MabrozKhan/rfid-plattenspieler/cad/fit_tests/round1/overview.png

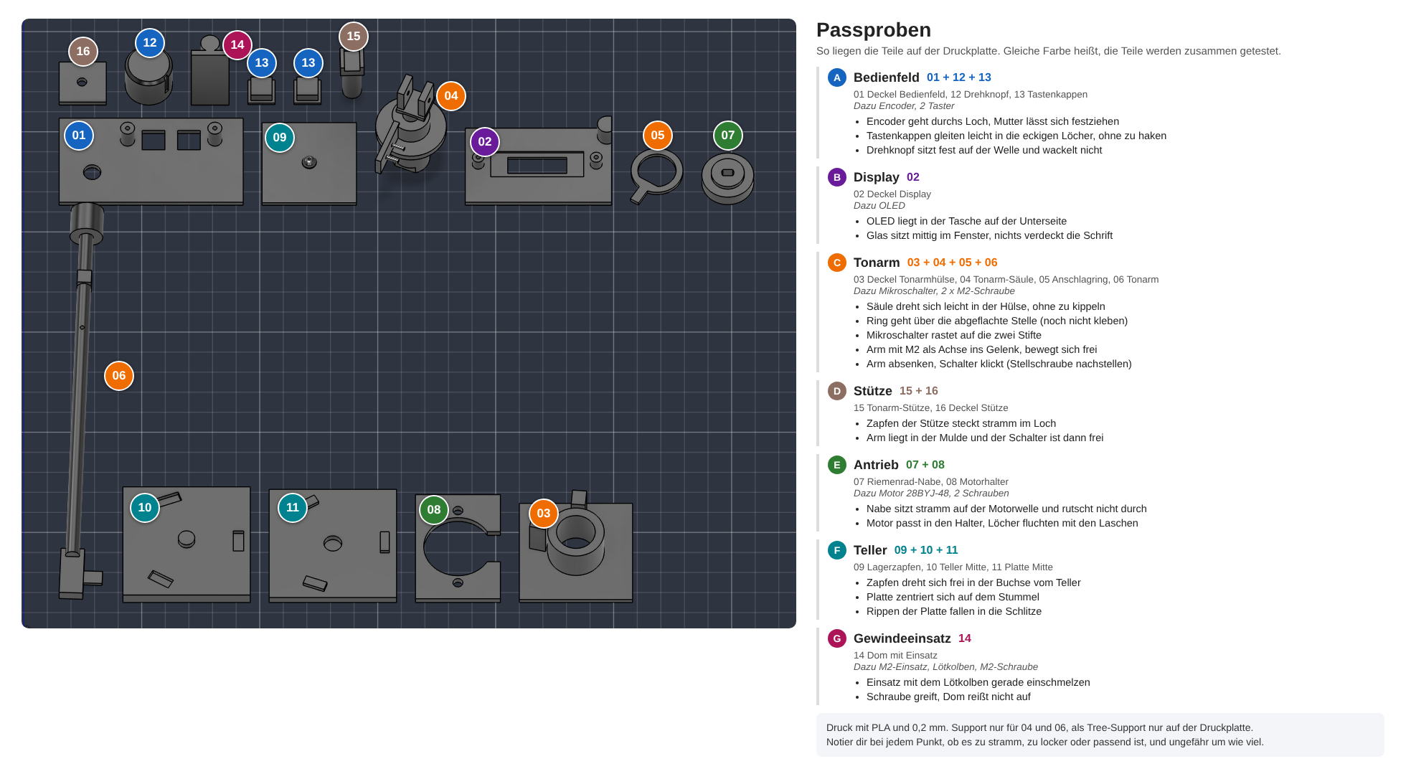
cad/fit_tests/round1/overview.png
