MabrozKhan/rfid-plattenspieler/cad/druck/19_Tastenkappe_Zurueck_links_schwarz.stl

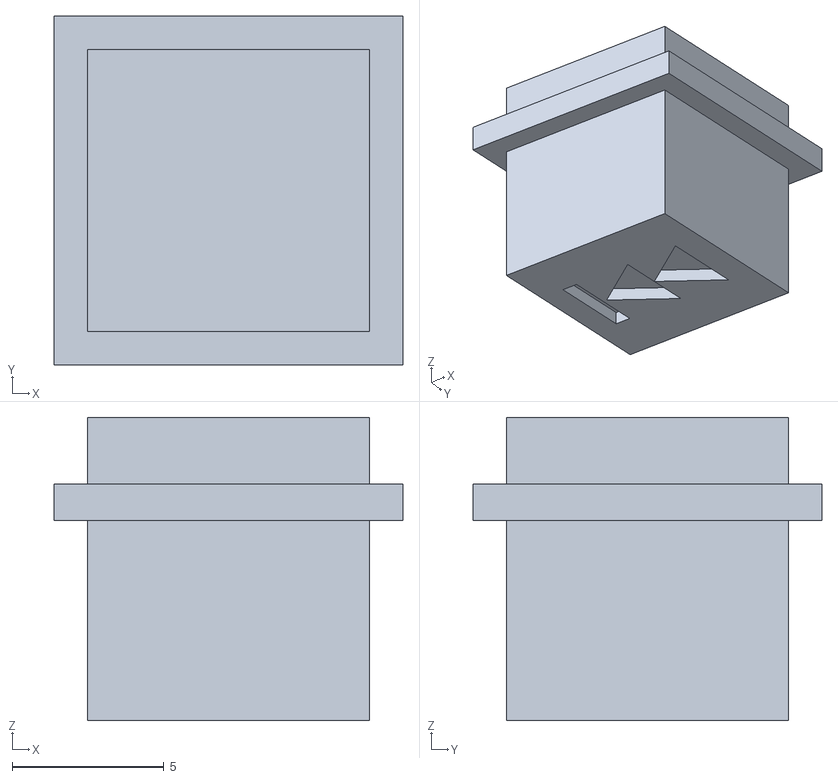
[picture p5: CAD file, 2026-10-21]
cad/druck/19_Tastenkappe_Zurueck_links_schwarz.stl
11.5 x 11.5 x 10.0
