MabrozKhan/rfid-plattenspieler/cad/fit_tests/round1/plattenspieler_passproben.3mf

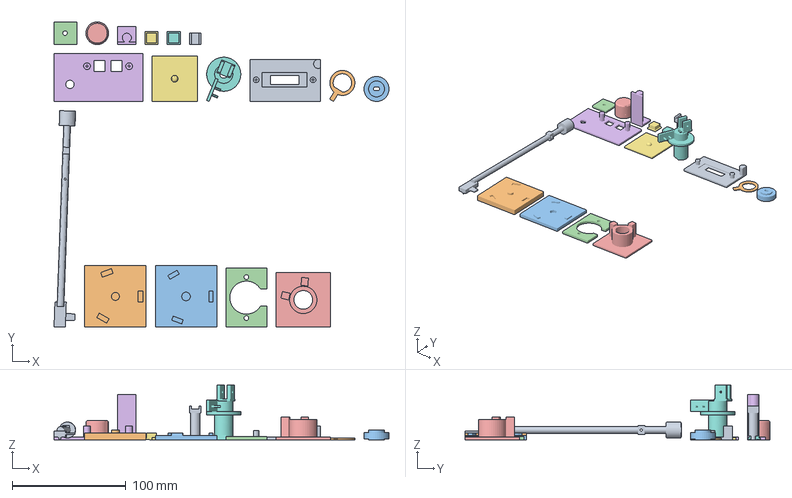
[picture p6: CAD file, 2026-10-11]
cad/fit_tests/round1/plattenspieler_passproben.3mf
294.3 x 268.3 x 48.0 mm
06_Tonarm_Arm
10_Teller_Mitte
11_Platte_Mitte
08_Motorhalter
03_Deckel_Tonarm
01_Deckel_Bedienung
09_Lagerzapfen
04_Tonarm_Saeule
02_Deckel_Display
05_Tonarm_Anschlagring
07_Riemenrad_Nabe
16_Deckel_Stuetze
12_Drehknopf
14_Dom_Einsatz
13_Tastenkappe_1
13_Tastenkappe_2
15_Tonarm_Stuetze
