MabrozKhan/rfid-plattenspieler/cad/fit_tests/round1/stl/07_Riemenrad_Nabe.stl

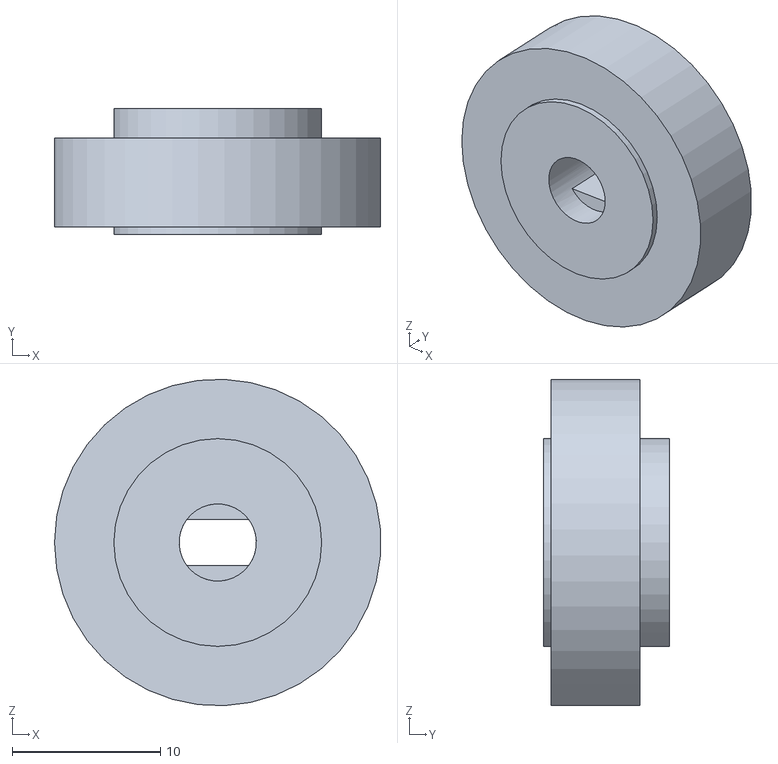
[picture p7: CAD file, 2026-10-11]
cad/fit_tests/round1/stl/07_Riemenrad_Nabe.stl
22.0 x 8.50 x 22.0
