MabrozKhan/rfid-plattenspieler/cad/fit_tests/round2/plattenspieler_tonarm.3mf

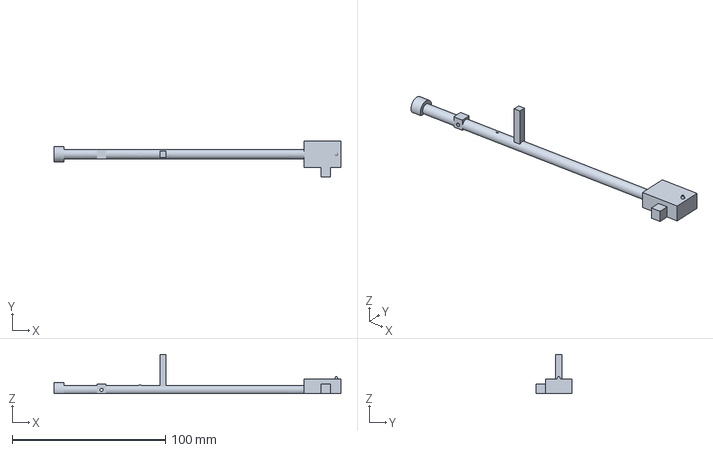
[picture p8: CAD file, 2026-10-12]
cad/fit_tests/round2/plattenspieler_tonarm.3mf
187.0 x 23.8 x 25.6 mm
