MabrozKhan/rfid-plattenspieler/cad/fit_tests/round2/stl/11_Tastenkappe_Test_unten_1-8mm.stl

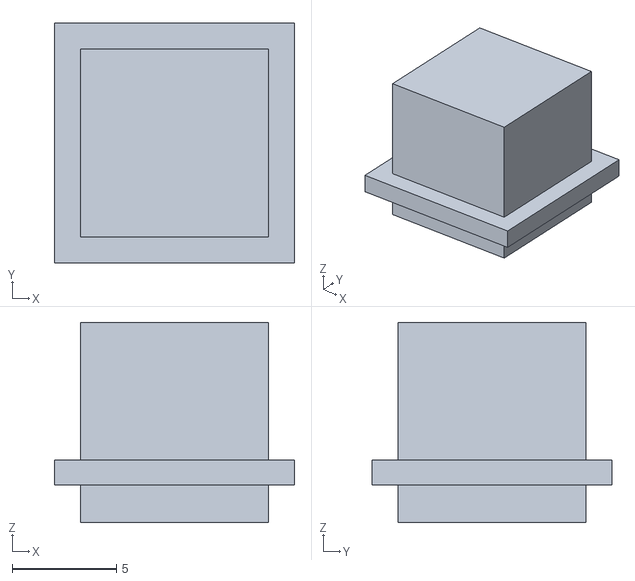
[picture p9: CAD file, 2026-10-21]
cad/fit_tests/round2/stl/11_Tastenkappe_Test_unten_1-8mm.stl
11.5 x 11.5 x 9.60
