MabrozKhan/rfid-plattenspieler/cad/print/06b_switch_lever_shim_5x6x1-8_grey.stl

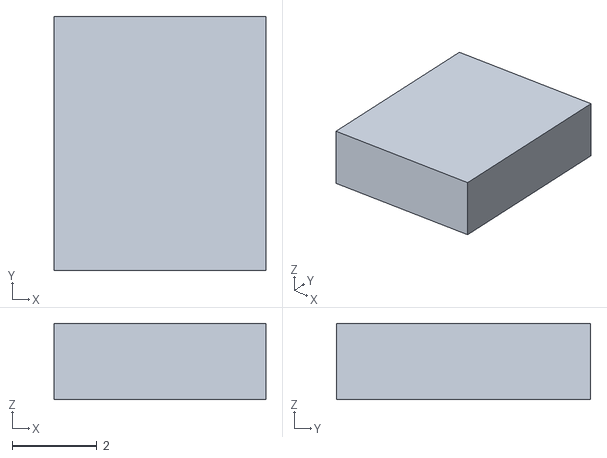
[picture p10: CAD file, 2026-10-23]
cad/print/06b_switch_lever_shim_5x6x1-8_grey.stl
5.00 x 6.00 x 1.80
