MabrozKhan/rfid-plattenspieler/cad/fit_tests/round1/stl/09_Lagerzapfen.stl

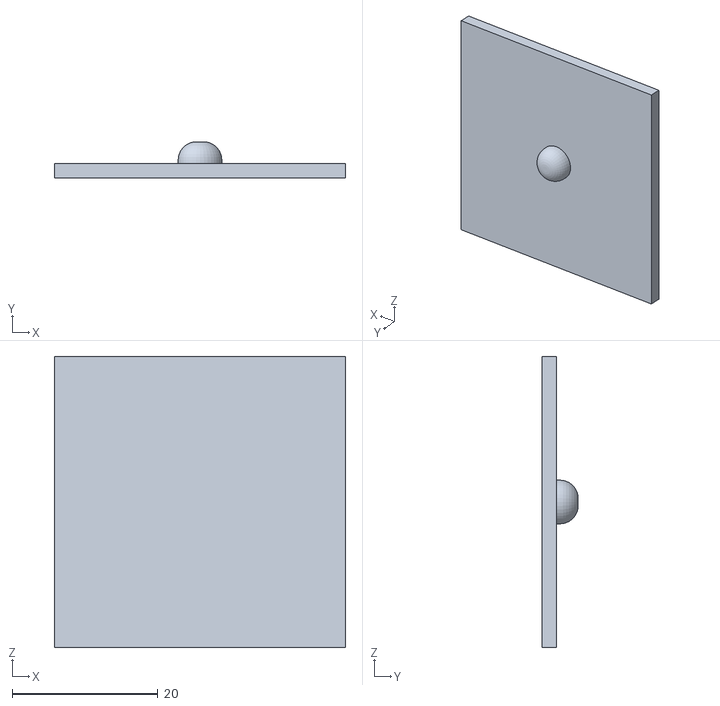
[picture p11: CAD file, 2026-10-11]
cad/fit_tests/round1/stl/09_Lagerzapfen.stl
40.0 x 5.00 x 40.0
