MabrozKhan/rfid-plattenspieler/cad/fit_tests/round2/m2_stift_20mm.stl

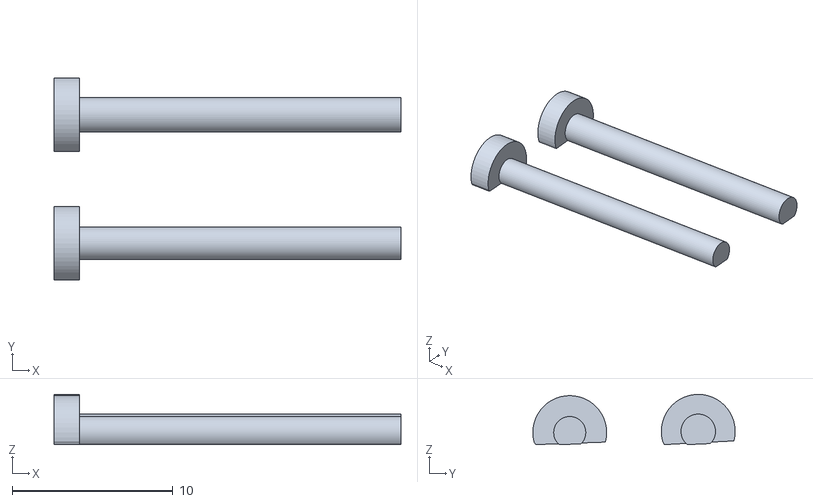
[picture p12: CAD file, 2026-10-12]
cad/fit_tests/round2/m2_stift_20mm.stl
21.6 x 12.6 x 3.12
