MabrozKhan/rfid-plattenspieler/cad/fit_tests/round2/stl/10_Tastenkappe_Test_unten_2-2mm.stl

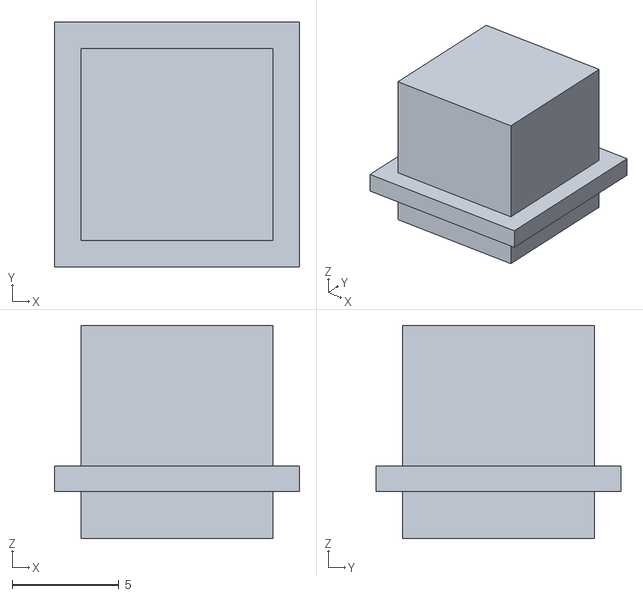
[picture p13: CAD file, 2026-10-21]
cad/fit_tests/round2/stl/10_Tastenkappe_Test_unten_2-2mm.stl
11.5 x 11.5 x 10.0
