MabrozKhan/rfid-plattenspieler/cad/print/04b_thrust_ring_grey.stl

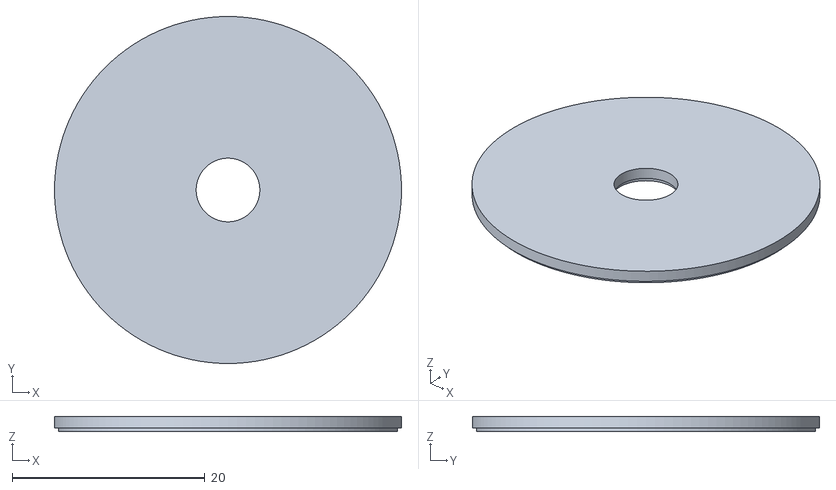
[picture p14: CAD file, 2026-10-23]
cad/print/04b_thrust_ring_grey.stl
36.0 x 36.0 x 1.60
