MabrozKhan/rfid-plattenspieler/cad/fit_tests/round1/stl/03_Deckel_Tonarm_FLIP.stl

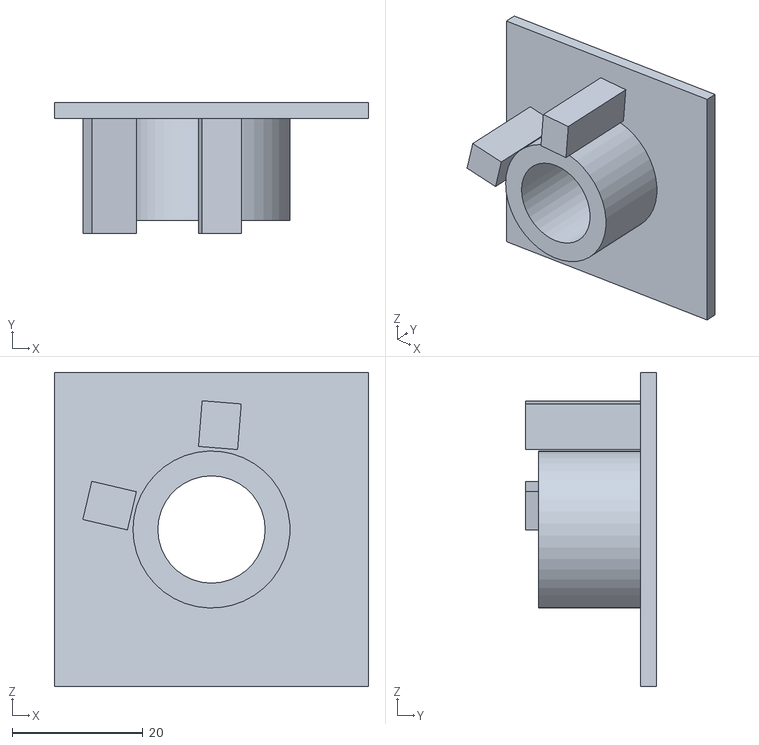
[picture p15: CAD file, 2026-10-11]
cad/fit_tests/round1/stl/03_Deckel_Tonarm_FLIP.stl
48.0 x 20.0 x 48.0
