MabrozKhan/rfid-plattenspieler/cad/fit_tests/round2/plattenspieler_passproben2.3mf

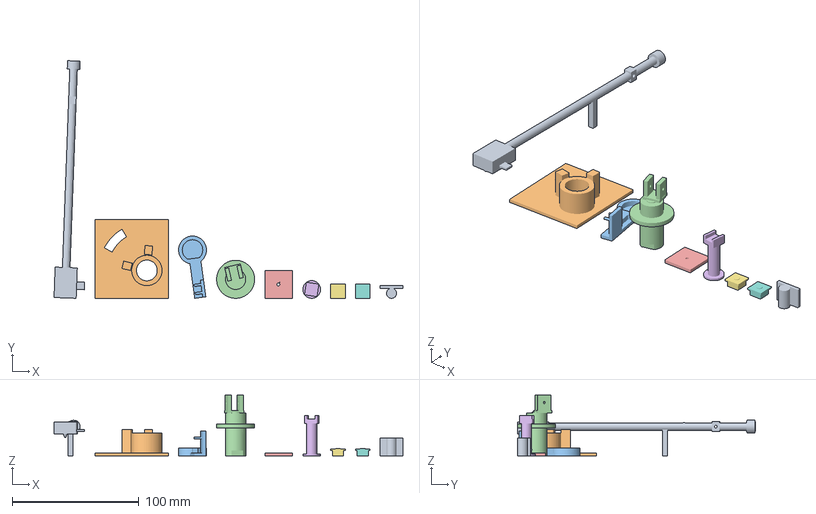
[picture p16: CAD file, 2026-10-12]
cad/fit_tests/round2/plattenspieler_passproben2.3mf
275.1 x 187.4 x 48.0 mm
04_Tonarm_Arm
01_Deckel_Tonarm_Schlitz
03_Ring_Schaltertraeger
02_Tonarm_Saeule
06_Deckel_Stuetze
05_Tonarm_Stuetze
07_Tastenkappe_1
07_Tastenkappe_2
08_Dom_Schraube
