MabrozKhan/rfid-plattenspieler/cad/print/05d_tensioner_set_grey.stl

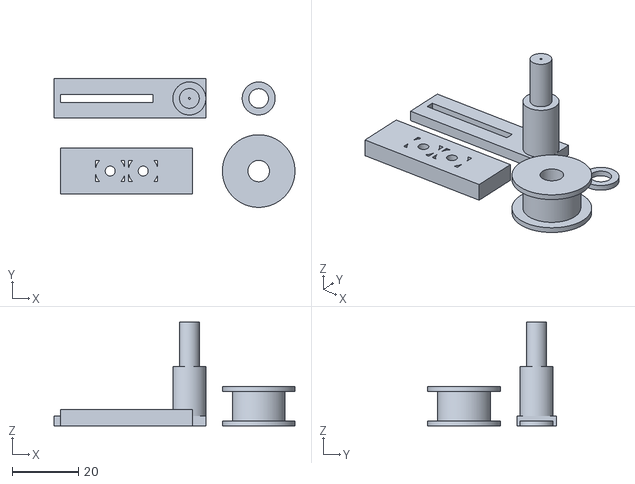
[picture p17: CAD file, 2026-10-23]
cad/print/05d_tensioner_set_grey.stl
73.0 x 39.0 x 31.5
