MabrozKhan/rfid-plattenspieler/cad/fit_tests/round1/stl/14_Dom_Einsatz_FLIP.stl

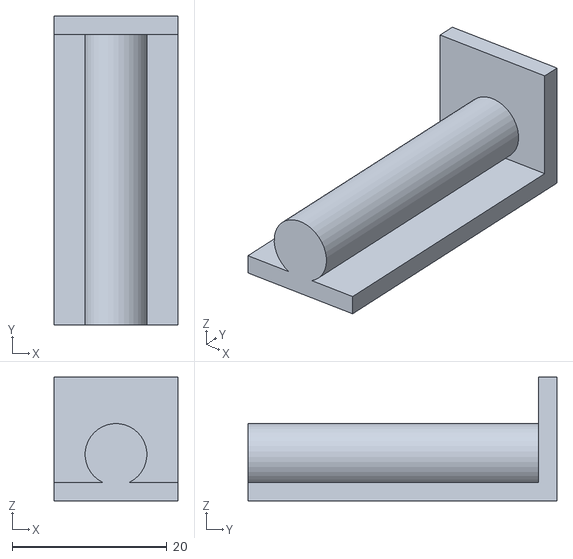
[picture p18: CAD file, 2026-10-11]
cad/fit_tests/round1/stl/14_Dom_Einsatz_FLIP.stl
16.0 x 40.0 x 16.0
