MabrozKhan/rfid-plattenspieler/cad/print/06b_switch_lever_shims_grey.stl

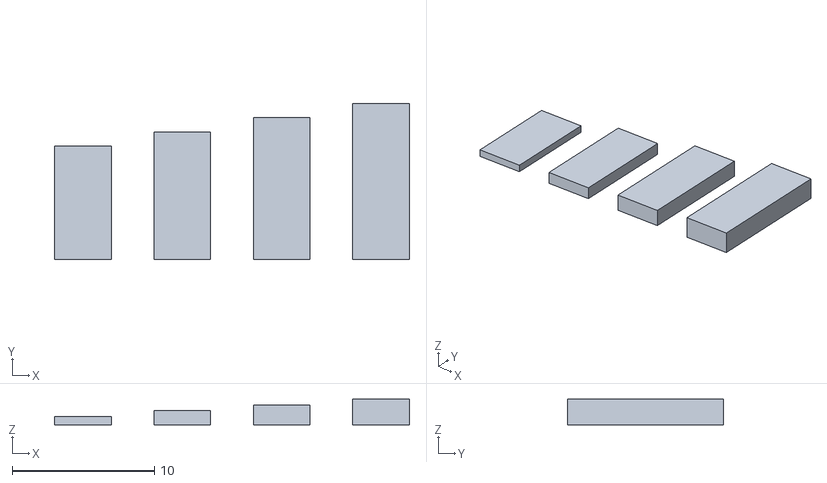
[picture p19: CAD file, 2026-10-22]
cad/print/06b_switch_lever_shims_grey.stl
25.0 x 11.0 x 1.80
