MabrozKhan/rfid-plattenspieler/cad/fit_tests/round1/stl/13_Tastenkappe_2.stl

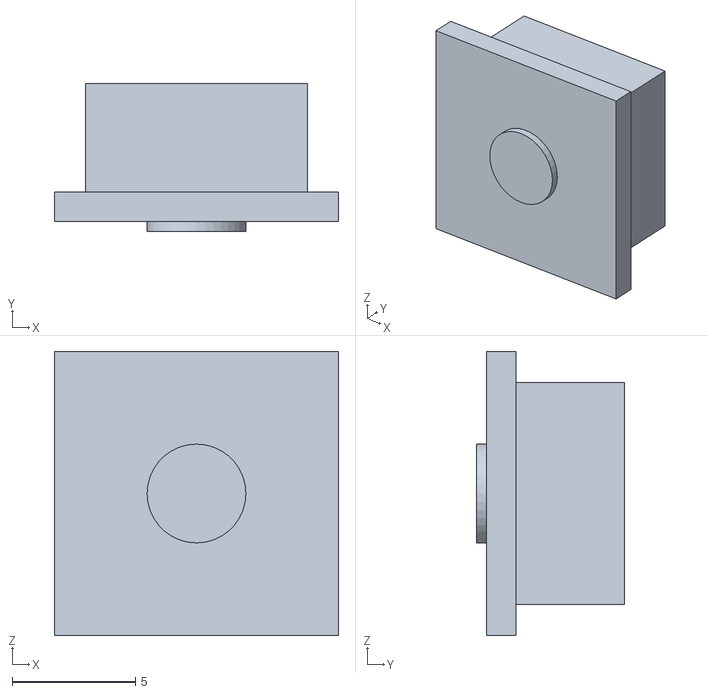
[picture p20: CAD file, 2026-10-11]
cad/fit_tests/round1/stl/13_Tastenkappe_2.stl
11.5 x 6.00 x 11.5
