MabrozKhan/rfid-plattenspieler/cad/fit_tests/round2/stl/08_Dom_Schraube.stl

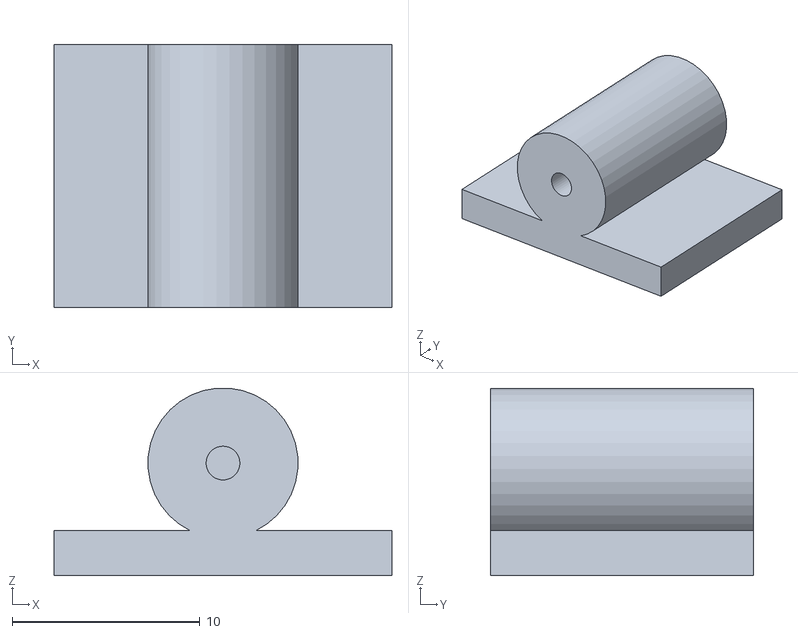
[picture p21: CAD file, 2026-10-12]
cad/fit_tests/round2/stl/08_Dom_Schraube.stl
18.0 x 14.0 x 9.98
