MabrozKhan/rfid-plattenspieler/cad/print/11b_name_plate_text_inlay_grey.stl

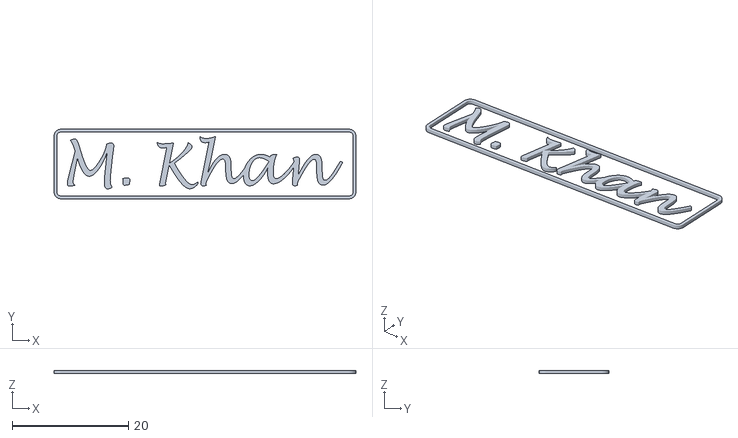
[picture p22: CAD file, 2026-10-21]
cad/print/11b_name_plate_text_inlay_grey.stl
52.0 x 12.0 x 0.6
