MabrozKhan/rfid-plattenspieler/cad/fit_tests/round1/stl/08_Motorhalter.stl

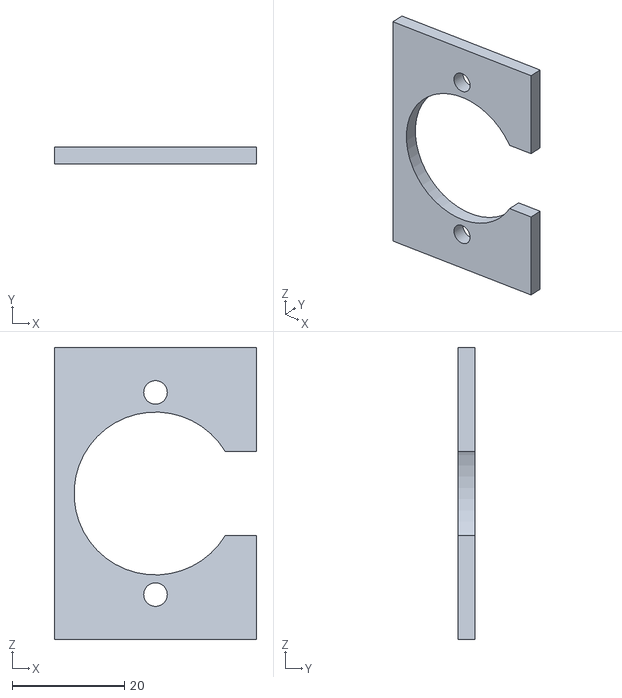
[picture p23: CAD file, 2026-10-11]
cad/fit_tests/round1/stl/08_Motorhalter.stl
36.0 x 3.00 x 52.0
