MabrozKhan/rfid-plattenspieler/cad/fit_tests/round2/stl/06_Deckel_Stuetze_FLIP.stl

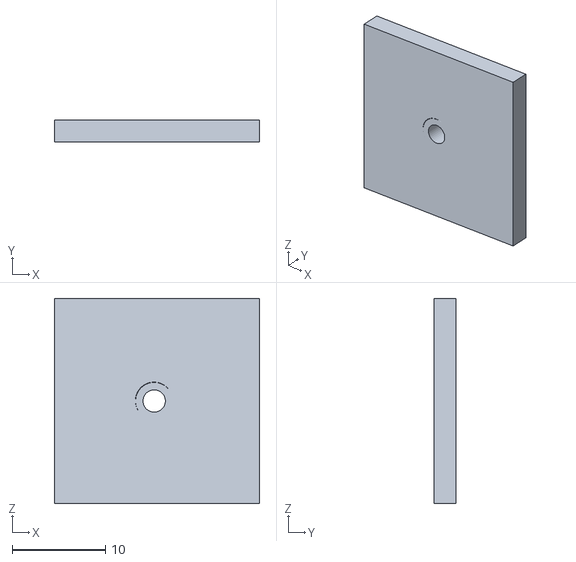
[picture p24: CAD file, 2026-10-12]
cad/fit_tests/round2/stl/06_Deckel_Stuetze_FLIP.stl
22.0 x 2.40 x 22.0
