MabrozKhan/rfid-plattenspieler/cad/fit_tests/round1/stl/04_Tonarm_Saeule.stl

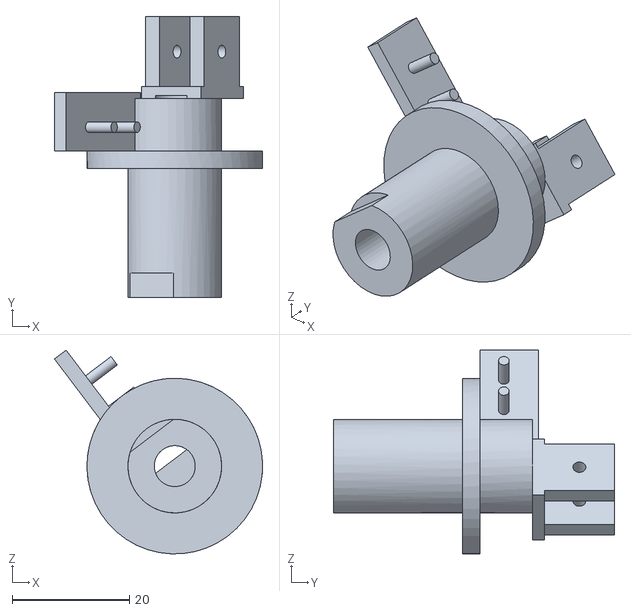
[picture p25: CAD file, 2026-10-11]
cad/fit_tests/round1/stl/04_Tonarm_Saeule.stl
35.6 x 48.0 x 34.8
