MabrozKhan/rfid-plattenspieler/cad/fit_tests/round2/stl/01_Deckel_Tonarm_Schlitz_FLIP.stl

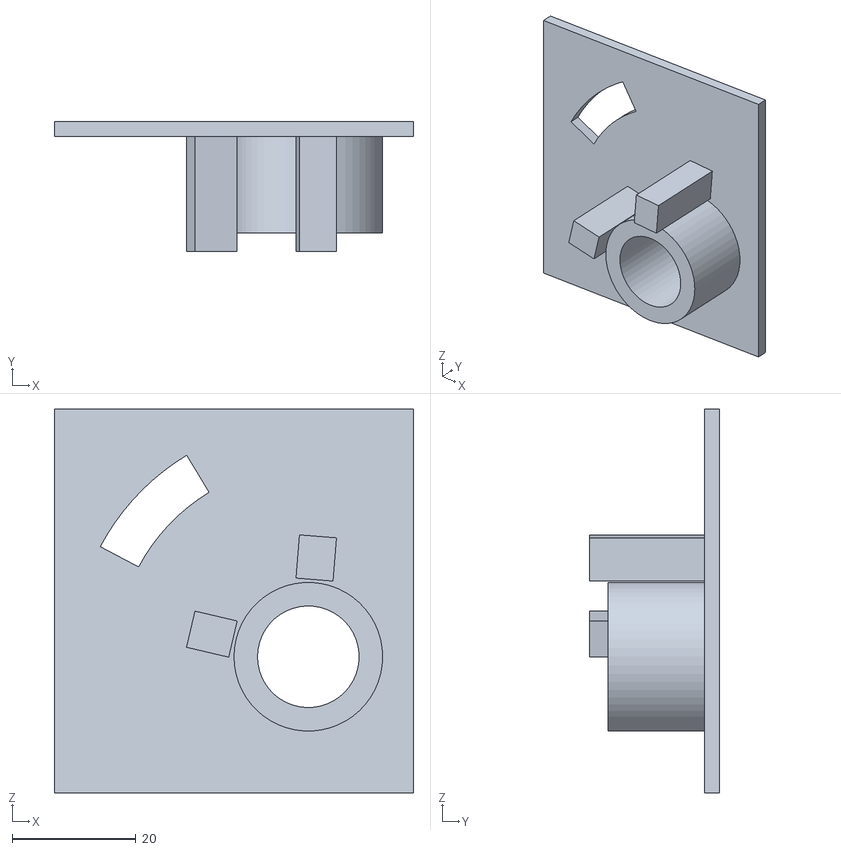
[picture p26: CAD file, 2026-10-12]
cad/fit_tests/round2/stl/01_Deckel_Tonarm_Schlitz_FLIP.stl
58.0 x 21.0 x 62.0
