MabrozKhan/rfid-plattenspieler/cad/print/12b_centre_spindle_black.stl

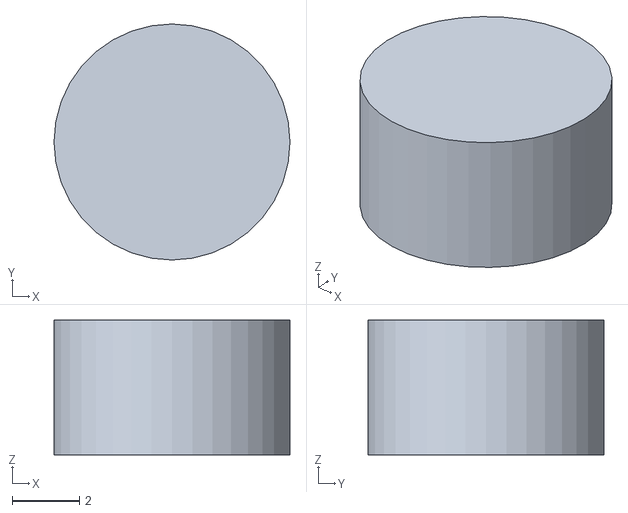
[picture p27: CAD file, 2026-10-21]
cad/print/12b_centre_spindle_black.stl
7.00 x 7.00 x 4.00
