MabrozKhan/rfid-plattenspieler/cad/fit_tests/round1/stl/15_Tonarm_Stuetze.stl

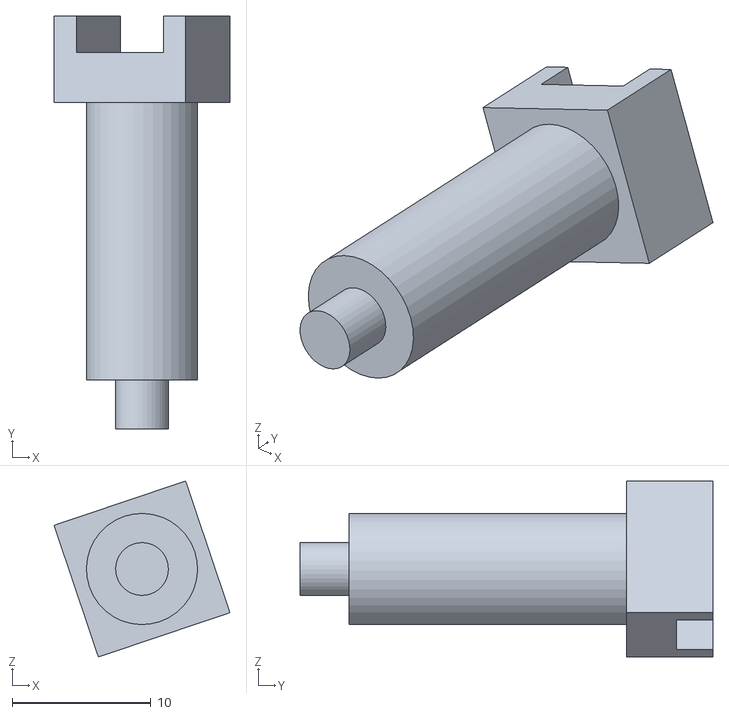
[picture p28: CAD file, 2026-10-11]
cad/fit_tests/round1/stl/15_Tonarm_Stuetze.stl
12.7 x 29.7 x 12.7
