MabrozKhan/rfid-plattenspieler/cad/fit_tests/round2/stl/02_Tonarm_Saeule.stl

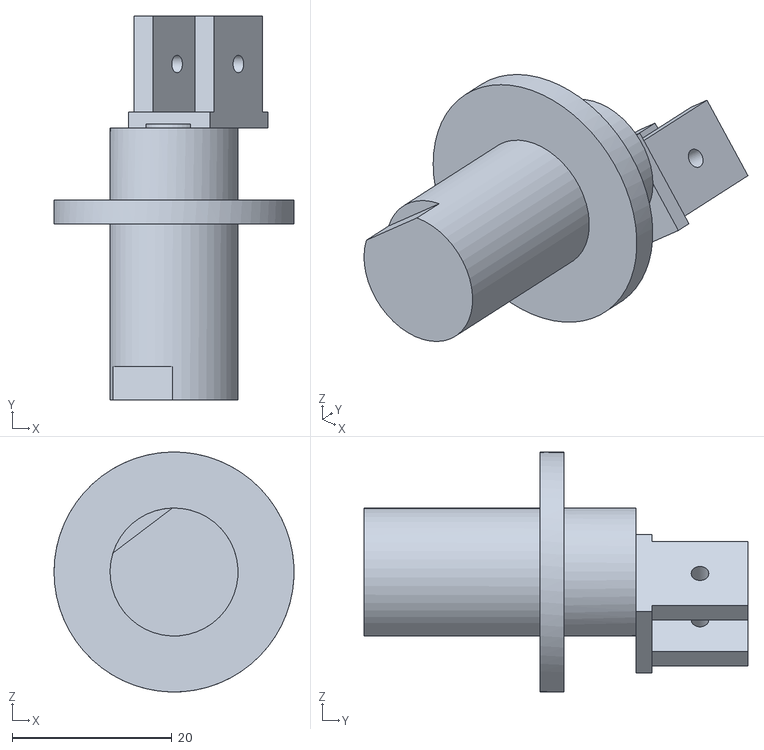
[picture p29: CAD file, 2026-10-12]
cad/fit_tests/round2/stl/02_Tonarm_Saeule.stl
30.0 x 48.0 x 30.0
