MabrozKhan/rfid-plattenspieler/cad/print/05_belt_pulley_grey.stl

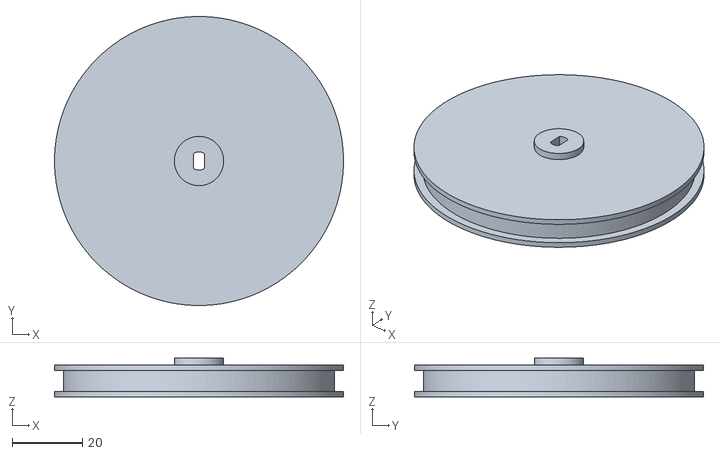
[picture p30: CAD file, 2026-10-21]
cad/print/05_belt_pulley_grey.stl
82.0 x 82.0 x 11.0
