MabrozKhan/rfid-plattenspieler/cad/fit_tests/round1/stl/16_Deckel_Stuetze_FLIP.stl

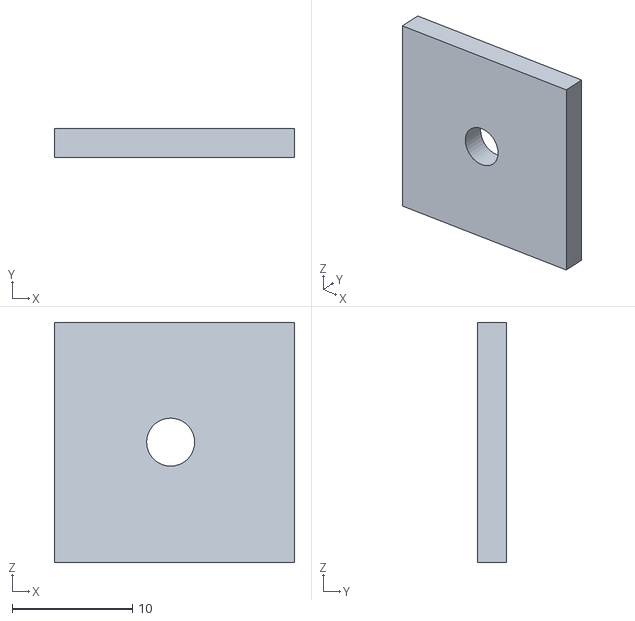
[picture p31: CAD file, 2026-10-11]
cad/fit_tests/round1/stl/16_Deckel_Stuetze_FLIP.stl
20.0 x 2.40 x 20.0
