MabrozKhan/rfid-plattenspieler/cad/fit_tests/round2/stl/03_Ring_Schaltertraeger.stl

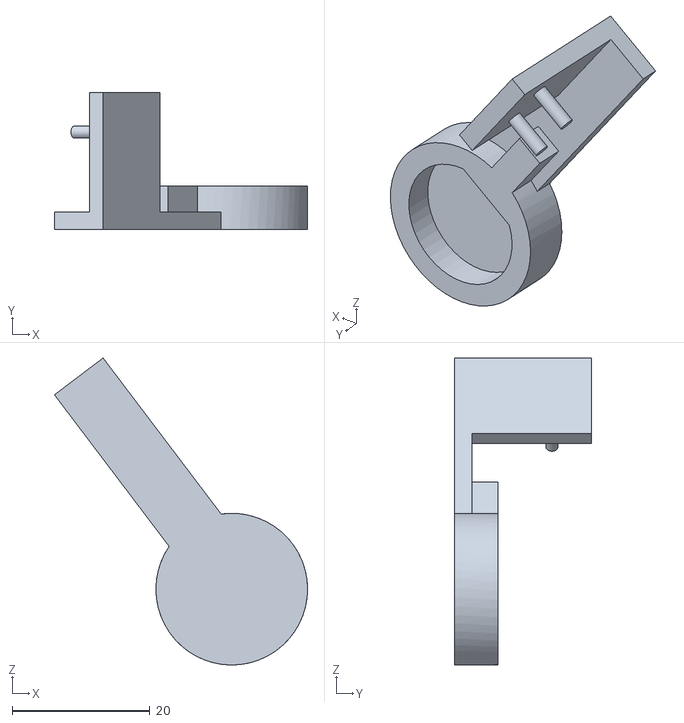
[picture p32: CAD file, 2026-10-12]
cad/fit_tests/round2/stl/03_Ring_Schaltertraeger.stl
36.7 x 19.8 x 44.5
