MabrozKhan/rfid-plattenspieler/cad/print/07b_encoder_support_grey.stl

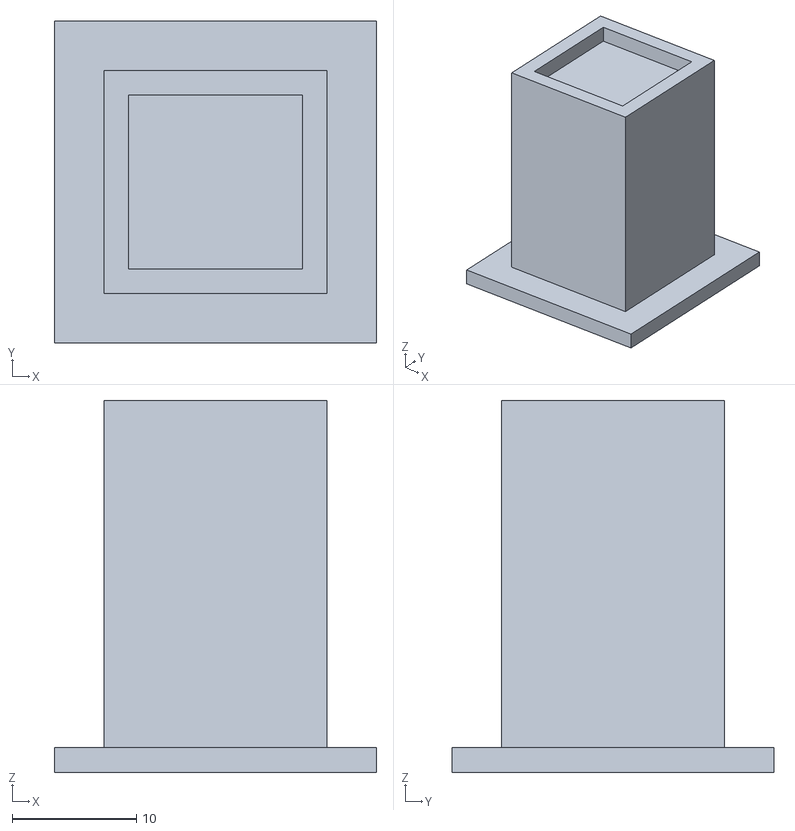
[picture p33: CAD file, 2026-10-21]
cad/print/07b_encoder_support_grey.stl
26.0 x 26.0 x 30.0
