MabrozKhan/rfid-plattenspieler/cad/fit_tests/round1/stl/01_Deckel_Bedienung_FLIP.stl

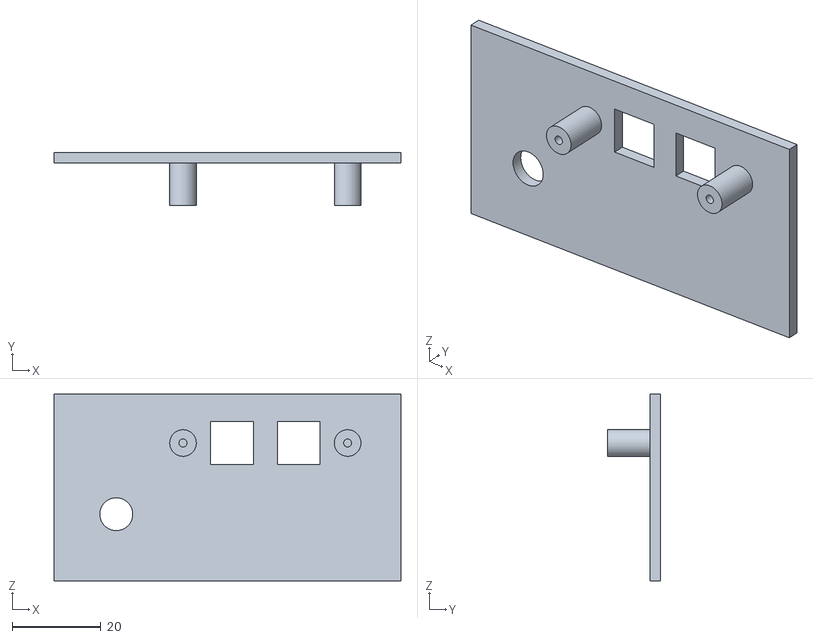
[picture p34: CAD file, 2026-10-11]
cad/fit_tests/round1/stl/01_Deckel_Bedienung_FLIP.stl
78.0 x 12.0 x 42.0
