MabrozKhan/rfid-plattenspieler/cad/fit_tests/round2/stl/05_Tonarm_Stuetze.stl

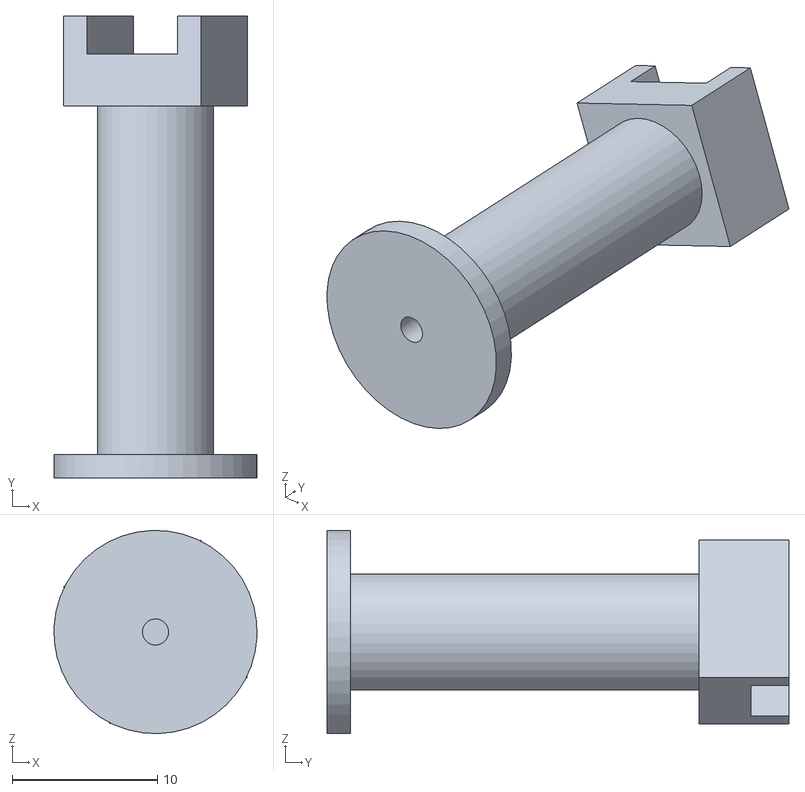
[picture p35: CAD file, 2026-10-12]
cad/fit_tests/round2/stl/05_Tonarm_Stuetze.stl
14.0 x 31.8 x 14.0
