MabrozKhan/rfid-plattenspieler/cad/print/05c_belt_cage_grey.stl

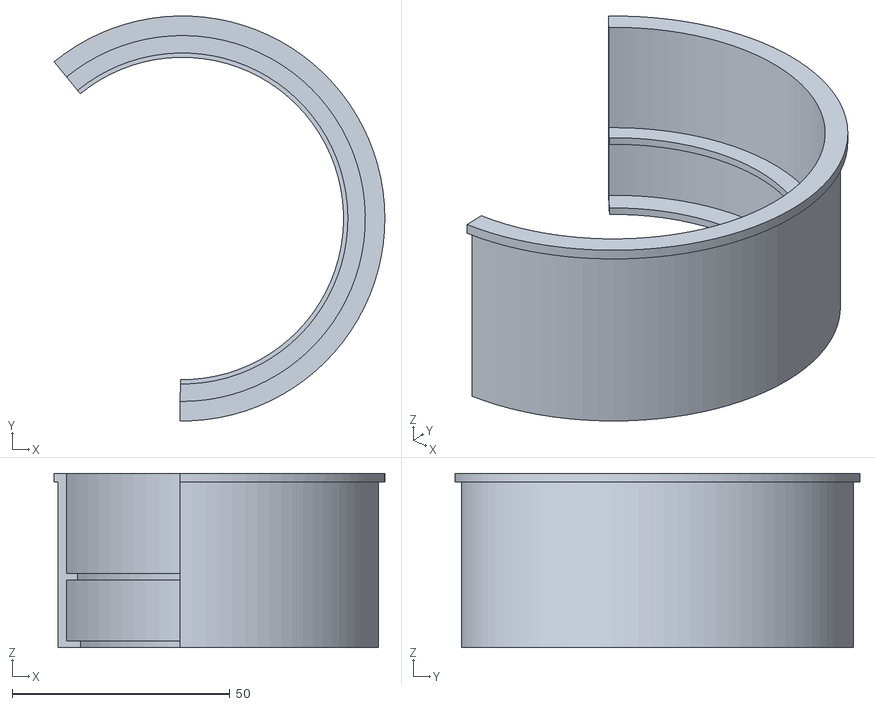
[picture p36: CAD file, 2026-10-21]
cad/print/05c_belt_cage_grey.stl
76.0 x 93.0 x 40.0
