MabrozKhan/rfid-plattenspieler/cad/fit_tests/round1/stl/05_Tonarm_Anschlagring.stl

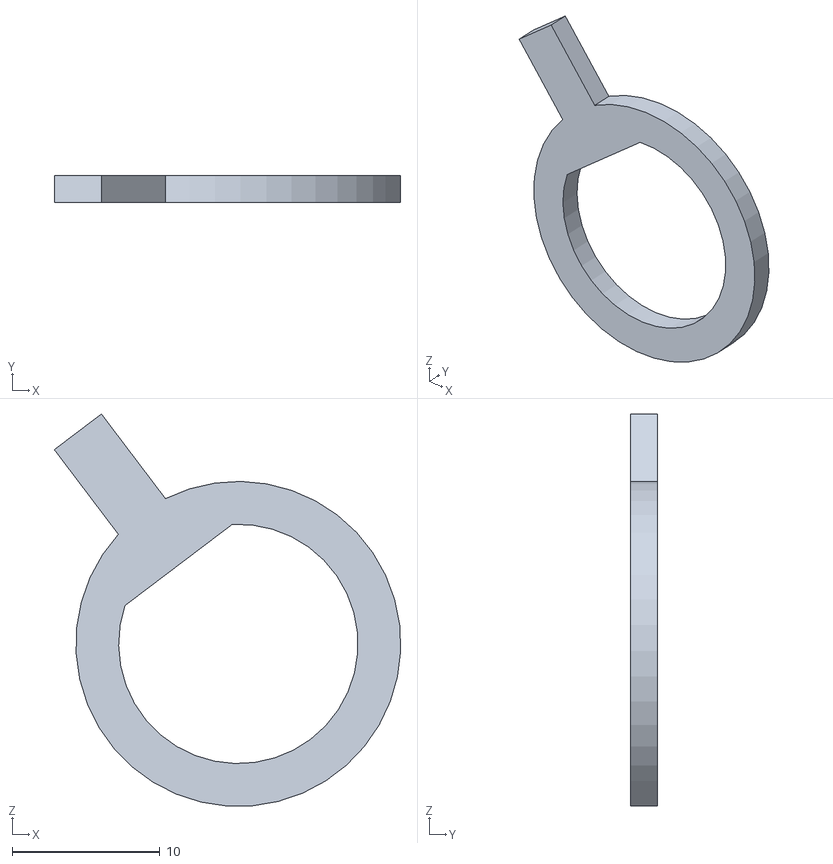
[picture p37: CAD file, 2026-10-11]
cad/fit_tests/round1/stl/05_Tonarm_Anschlagring.stl
23.4 x 1.80 x 26.5
