MabrozKhan/rfid-plattenspieler/cad/print/12c_hub_belt_groove_black.stl

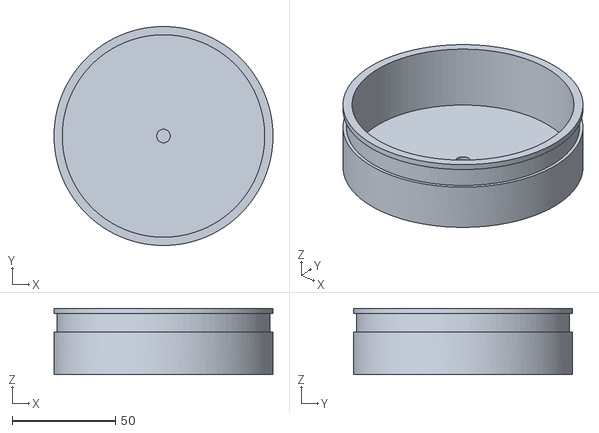
[picture p38: CAD file, 2026-10-21]
cad/print/12c_hub_belt_groove_black.stl
106.0 x 106.0 x 32.0
