MabrozKhan/rfid-plattenspieler/cad/print/12_platter_black.stl

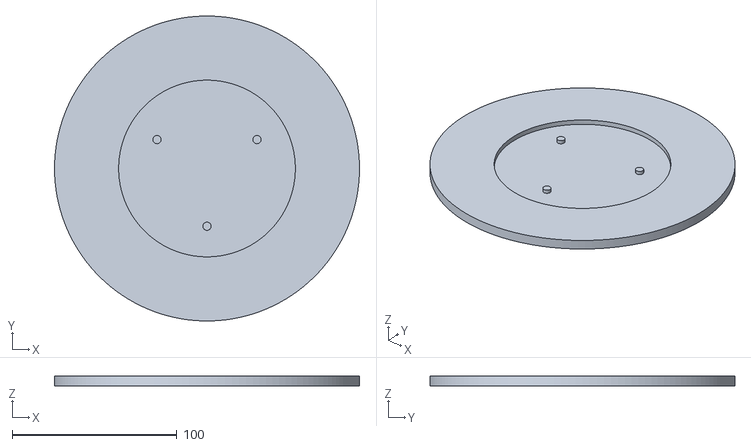
[picture p39: CAD file, 2026-10-21]
cad/print/12_platter_black.stl
185.0 x 184.9 x 6.00
