MabrozKhan/rfid-plattenspieler/cad/fit_tests/round1/stl/12_Drehknopf.stl

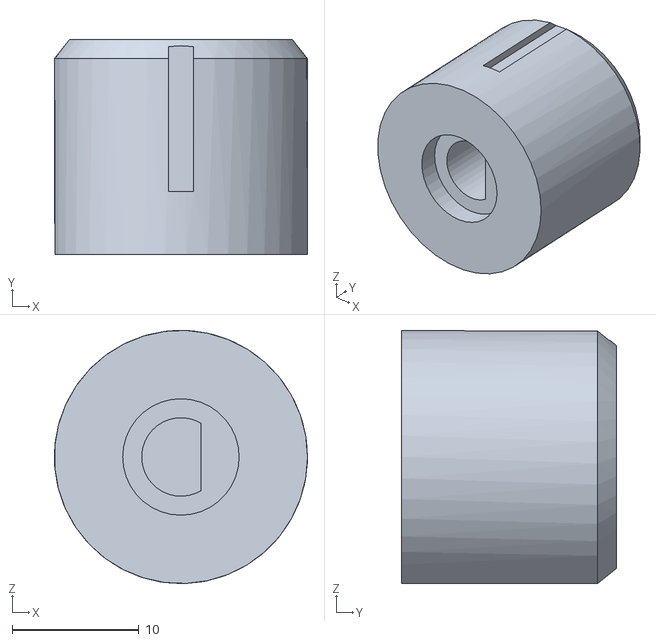
[picture p40: CAD file, 2026-10-11]
cad/fit_tests/round1/stl/12_Drehknopf.stl
20.0 x 17.0 x 20.0
