MabrozKhan/rfid-plattenspieler/cad/fit_tests/round1/stl/10_Teller_Mitte.stl

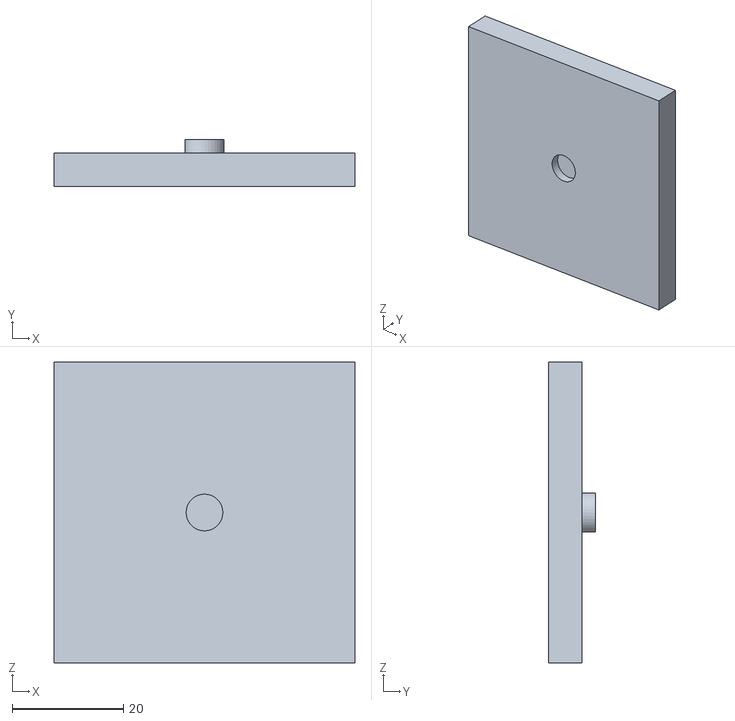
[picture p41: CAD file, 2026-10-11]
cad/fit_tests/round1/stl/10_Teller_Mitte.stl
54.0 x 8.50 x 54.0
