MabrozKhan/rfid-plattenspieler/cad/print/11_name_plate_AMS_two_colour.3mf

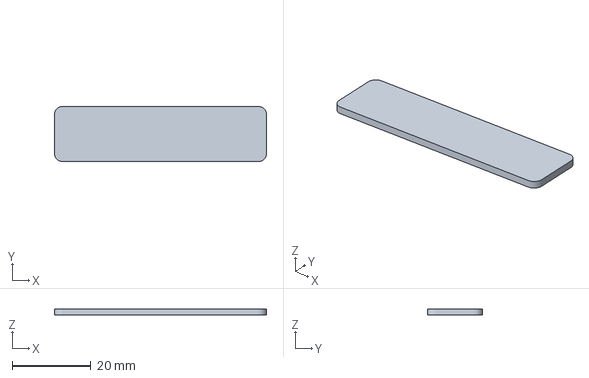
[picture p42: CAD file, 2026-10-21]
cad/print/11_name_plate_AMS_two_colour.3mf
54.0 x 14.0 x 1.60 mm
