MabrozKhan/rfid-plattenspieler/cad/fit_tests/round1/stl/11_Platte_Mitte_FLIP.stl

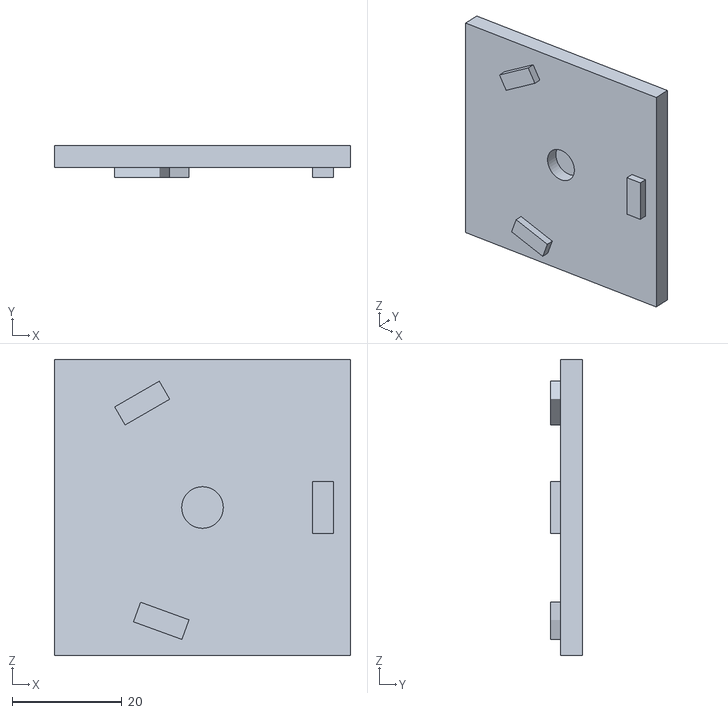
[picture p43: CAD file, 2026-10-11]
cad/fit_tests/round1/stl/11_Platte_Mitte_FLIP.stl
54.0 x 5.80 x 54.0
