MabrozKhan/rfid-plattenspieler/cad/print/11_name_plate_grey_black_from_1-0mm.stl

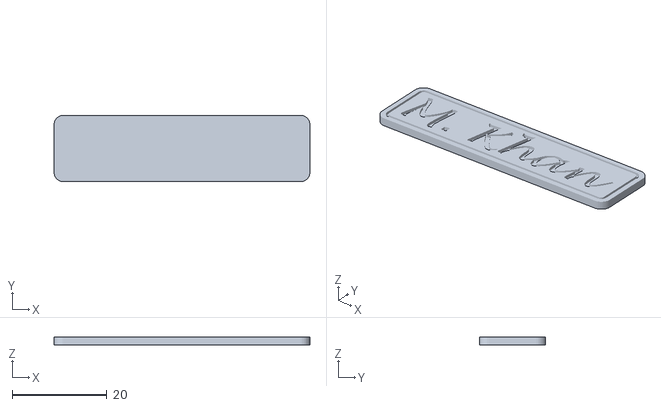
[picture p44: CAD file, 2026-10-13]
cad/print/11_name_plate_grey_black_from_1-0mm.stl
54.0 x 14.0 x 1.60
