MabrozKhan/rfid-plattenspieler/cad/fit_tests/round1/stl/02_Deckel_Display_FLIP.stl

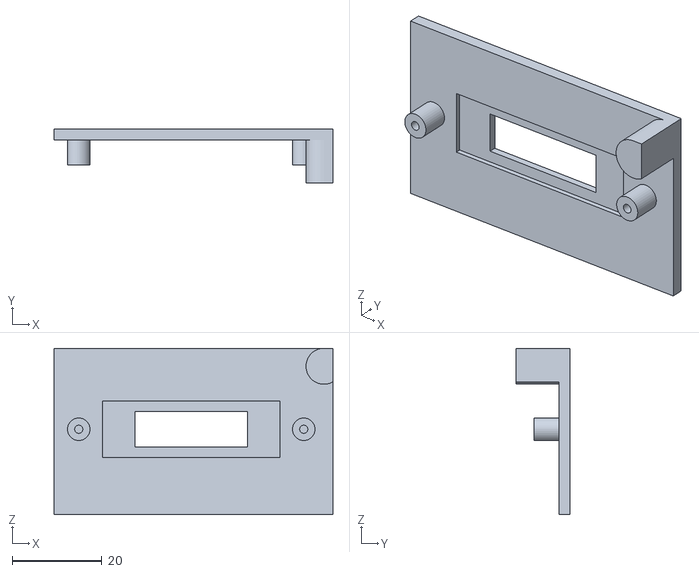
[picture p45: CAD file, 2026-10-11]
cad/fit_tests/round1/stl/02_Deckel_Display_FLIP.stl
62.0 x 12.0 x 37.0
