MabrozKhan/rfid-plattenspieler/cad/print/20_shuffle_puck_black.stl

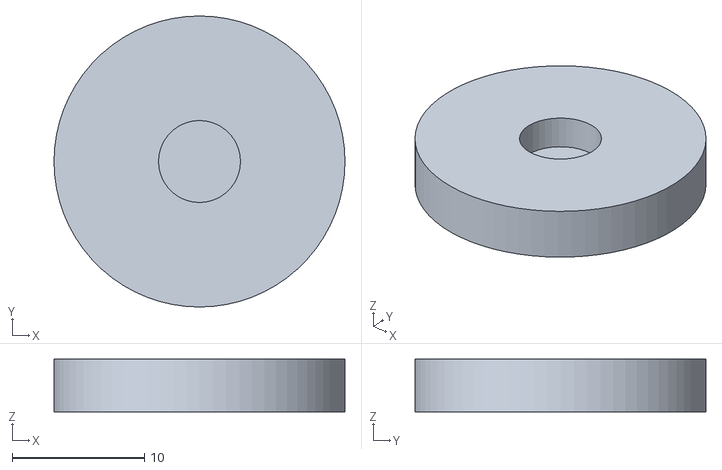
[picture p46: CAD file, 2026-10-13]
cad/print/20_shuffle_puck_black.stl
22.0 x 22.0 x 4.00
