MabrozKhan/rfid-plattenspieler/cad/fit_tests/round1/stl/06_Tonarm_Arm.stl

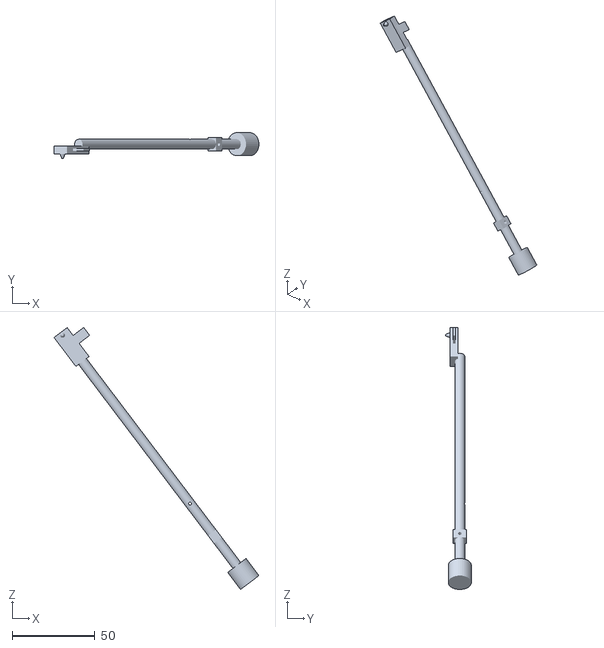
[picture p47: CAD file, 2026-10-11]
cad/fit_tests/round1/stl/06_Tonarm_Arm.stl
124.2 x 15.6 x 158.8
