MabrozKhan/rfid-plattenspieler/cad/print/09_shuffle_plunger_grey.stl

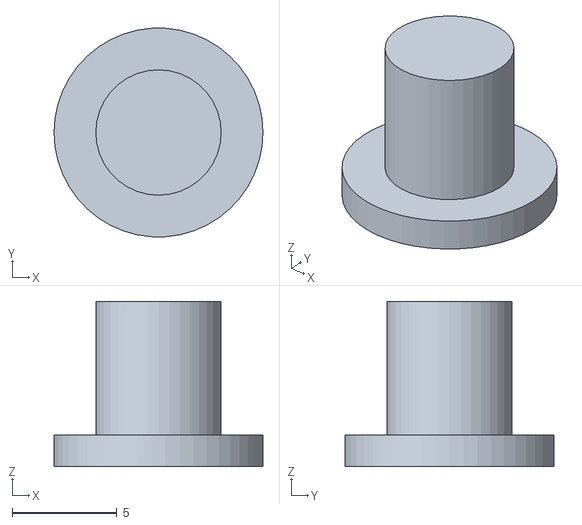
[picture p48: CAD file, 2026-10-13]
cad/print/09_shuffle_plunger_grey.stl
10.0 x 9.98 x 7.90
