MabrozKhan/rfid-plattenspieler/cad/print/10_shuffle_drill_template_grey.stl

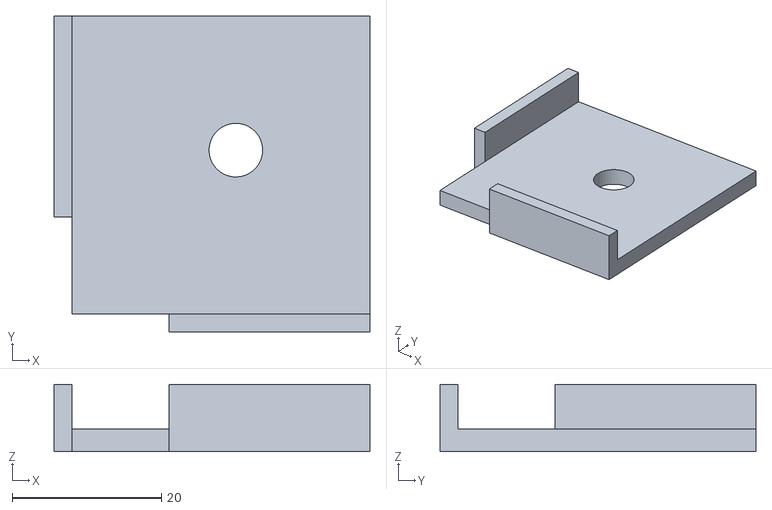
[picture p49: CAD file, 2026-10-13]
cad/print/10_shuffle_drill_template_grey.stl
42.4 x 42.4 x 9.00
