MabrozKhan/rfid-plattenspieler/cad/print/08_shuffle_holder_grey.stl

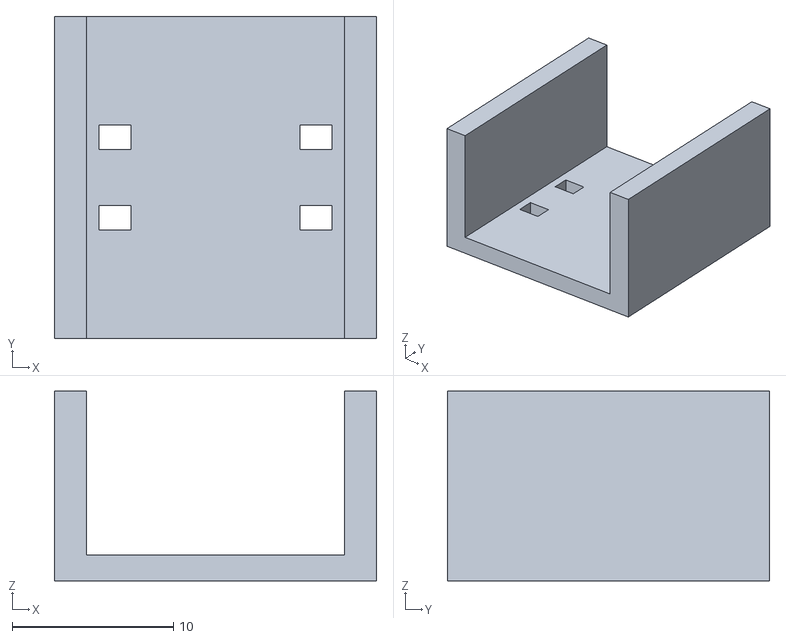
[picture p50: CAD file, 2026-10-13]
cad/print/08_shuffle_holder_grey.stl
20.0 x 20.0 x 11.8
