MabrozKhan/rfid-plattenspieler/cad/print/07_control_bracket_buttons_encoder_grey.stl

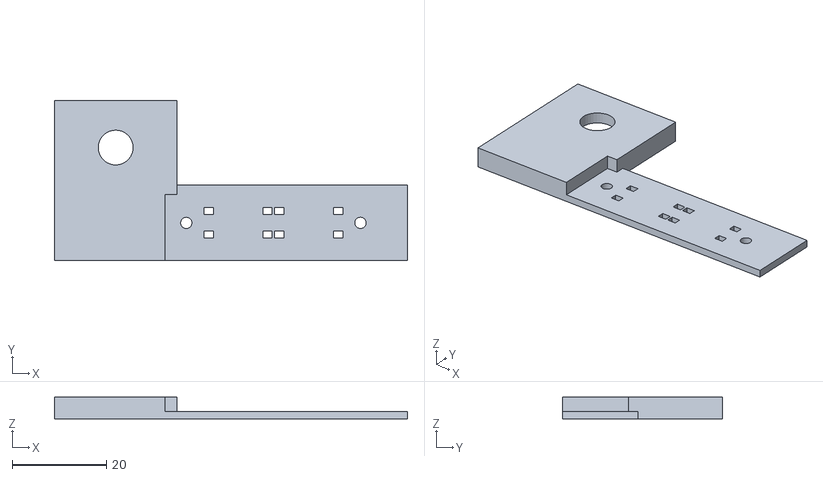
[picture p51: CAD file, 2026-10-13]
cad/print/07_control_bracket_buttons_encoder_grey.stl
75.0 x 34.0 x 4.60
