MabrozKhan/rfid-plattenspieler/cad/print/04_bearing_pin_grey.stl

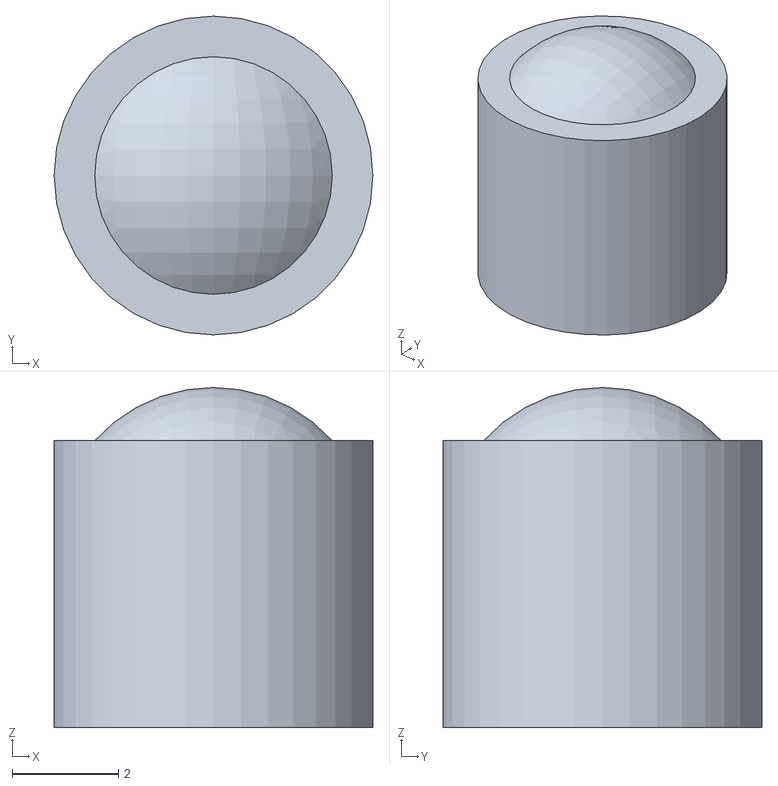
[picture p52: CAD file, 2026-10-12]
cad/print/04_bearing_pin_grey.stl
6.00 x 6.00 x 6.40
