MabrozKhan/rfid-plattenspieler/cad/print/13_record_black.stl

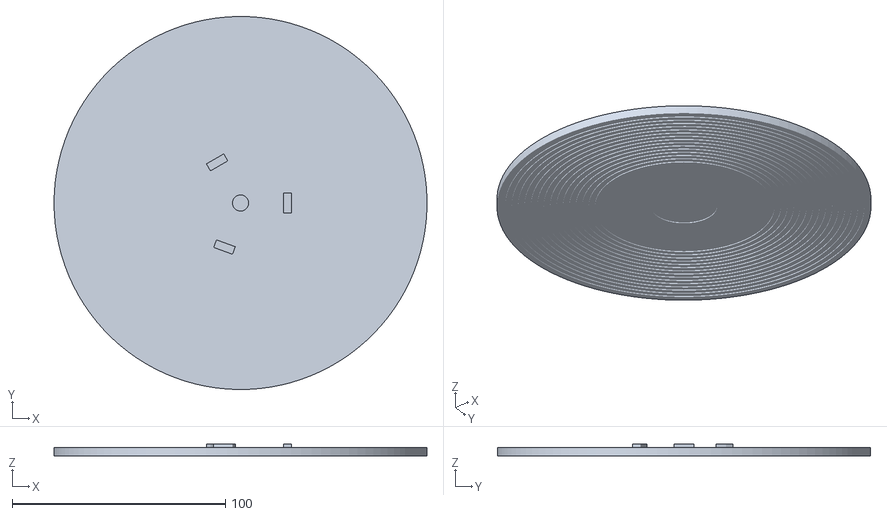
[picture p53: CAD file, 2026-10-12]
cad/print/13_record_black.stl
175.0 x 175.0 x 5.80
