MabrozKhan/rfid-plattenspieler/cad/print/03_bearing_cover_grey.stl

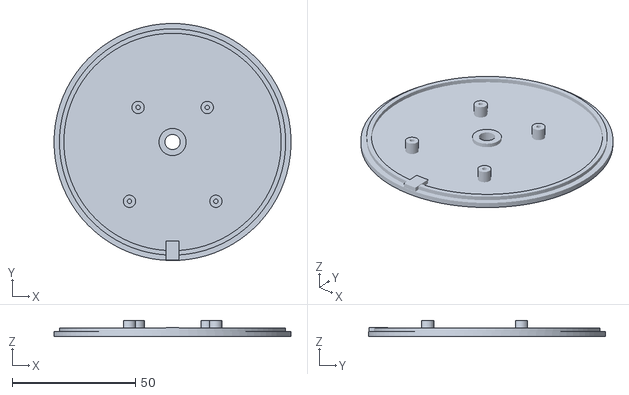
[picture p54: CAD file, 2026-10-12]
cad/print/03_bearing_cover_grey.stl
96.0 x 96.0 x 6.50
