MabrozKhan/rfid-plattenspieler/cad/print/02_base_plate_grey.stl

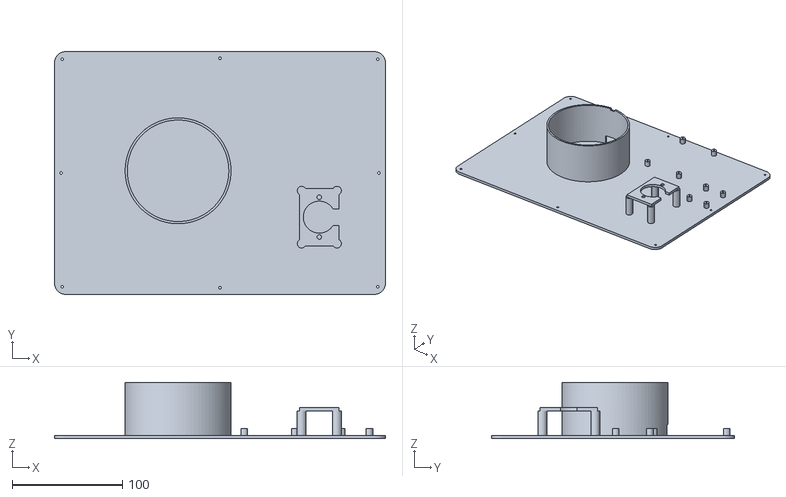
[picture p55: CAD file, 2026-10-12]
cad/print/02_base_plate_grey.stl
300.0 x 220.0 x 51.0
