MabrozKhan/rfid-plattenspieler/cad/print/21_foot_2_black.stl

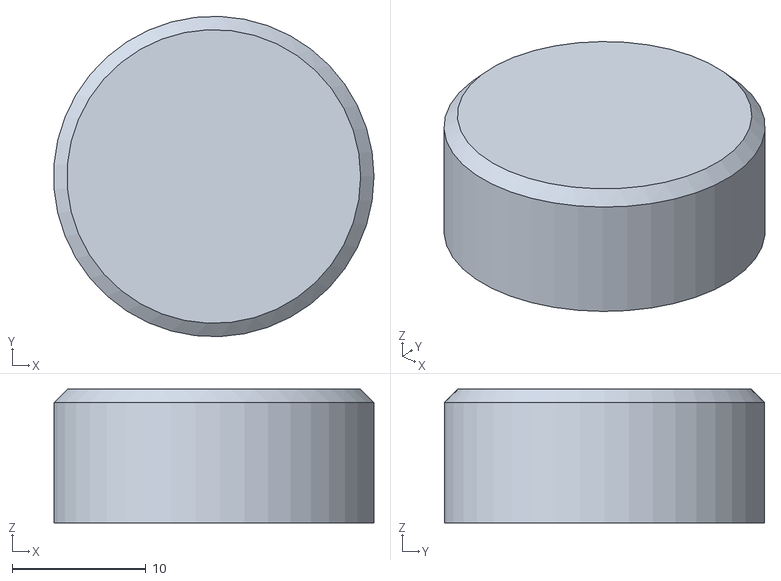
[picture p56: CAD file, 2026-10-12]
cad/print/21_foot_2_black.stl
24.0 x 24.0 x 10.0
