MabrozKhan/rfid-plattenspieler/cad/print/15_tonearm_black_PAUSE_8-6mm.stl

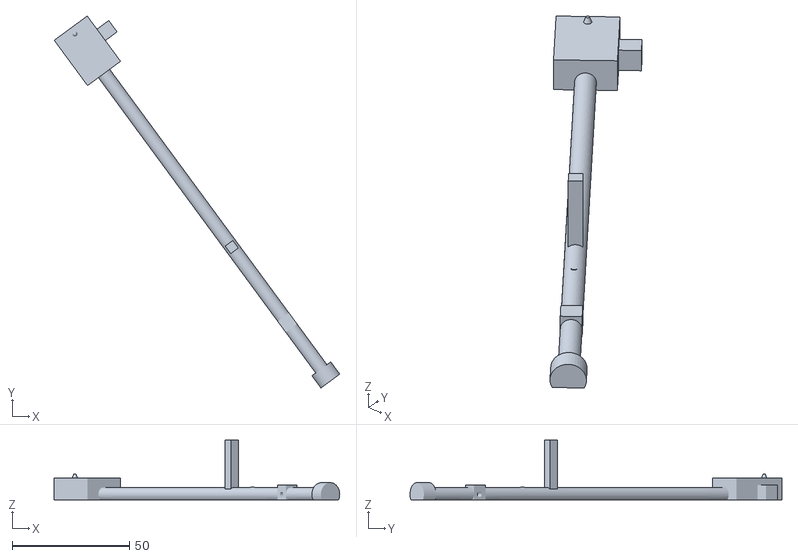
[picture p57: CAD file, 2026-10-12]
cad/print/15_tonearm_black_PAUSE_8-6mm.stl
121.9 x 158.8 x 25.6
