MabrozKhan/rfid-plattenspieler/cad/print/01_top_case_grey.stl

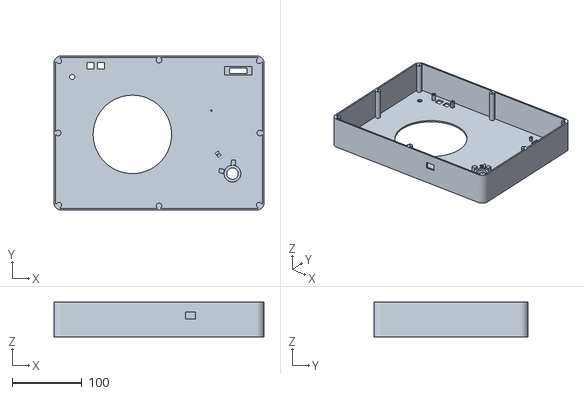
[picture p58: CAD file, 2026-10-12]
cad/print/01_top_case_grey.stl
300.0 x 220.0 x 50.0
