MabrozKhan/rfid-plattenspieler/(list of files, cad)

Other CAD files:
cad/fit_tests/round2/stl/09_Tastenkappe_gespiegelt_Test.stl
cad/fit_tests/round2/stl/04_Tonarm_Arm_FLIP.stl
cad/print/19_button_cap_next_right_black.stl
cad/fit_tests/round2/stl/07_Tastenkappe_1_FLIP.stl
cad/fit_tests/round1/stl/13_Tastenkappe_1.stl
cad/print/17_tonearm_rest_black.stl
cad/print/06_tonearm_stop_ring_grey.stl
cad/print/18_knob_black.stl
cad/print/21_foot_4_black.stl
cad/print/21_foot_3_black.stl
cad/print/14_tonearm_post_black.stl
