MabrozKhan/rfid-plattenspieler/firmware/turntable/secrets.example.h

// Template for the credentials.
// Copy this file to "secrets.h" and fill in your values.
// secrets.h is in .gitignore and never uploaded.
// No client secret needed, login uses PKCE (see tools/spotify_test.py).

#pragma once

#define WIFI_SSID             "YOUR_WIFI_NAME"
#define WIFI_PASSWORD         "YOUR_WIFI_PASSWORD"

#define SPOTIFY_CLIENT_ID     "YOUR_CLIENT_ID"
#define SPOTIFY_REFRESH_TOKEN "YOUR_REFRESH_TOKEN"
#define SPOTIFY_DEVICE_ID     "ID_OF_THE_ECHO"
