MabrozKhan/rfid-plattenspieler/(commit log)

2026-10-05 Projektstruktur, README und Projektplan angelegt
2026-10-07 RC522-Testsketch: UID und Rohdaten auslesen
2026-10-07 Firmware: Lautstärke-Poti, Skip-Taster, Platte startet immer von vorne
    - Poti an GPIO 34 regelt die Lautstärke (geglättet, sendet erst ab 3 % Änderung)
    - Taster an GPIO 32 und 33 für nächsten und vorherigen Titel
    - Auflegen startet Album/Playlist jetzt immer beim ersten Titel ab Sekunde 0
    - Fortsetzen bei gleicher Platte entfernt (hatte fremde Wiedergabe fortgesetzt)
    - Zufallswiedergabe wird nach dem Start ausgeschaltet
    - HTTPS-Anfragen schließen die Verbindung, Programm bleibt nicht mehr hängen
2026-10-07 Firmware: Schrittmotor dreht den Teller, solange Musik läuft
    - 28BYJ-48 über ULN2003 an GPIO 25, 26, 27, 14
    - Motor läuft in eigener FreeRTOS-Task, stockt nicht bei Spotify-Anfragen
    - Start nach erfolgreichem play, Stopp beim Wegnehmen der Platte
    - Spulen werden im Stand abgeschaltet
    - Drehzahl und Richtung oben im Code einstellbar
2026-10-10 Firmware V2: Tonarm-Schalter, Drehgeber, Spotify im Hintergrund mit offener Verbindung
    - Tonarm-Mikroschalter (GPIO 16): runter = Start/Weiter, hoch = Pause
    - Platte wegnehmen setzt zurück, nächstes Auflegen startet von vorne
    - Drehgeber KY-040 (CLK 34, DT 35, SW 13) ersetzt Poti: 5 % pro Raste, Druck = stumm
    - Lautstärke wird nach Leerlauf von Spotify gelesen (Sprachbefehle bleiben gültig)
    - Titel springen und Lautstärke auch in der Pause möglich
    - Spotify-Befehle in eigener Task, loop() blockiert nicht mehr
    - Dauerhafte HTTPS-Verbindung (keep-alive), eigenes schlankes HTTP
    - Aufträge werden zusammengefasst, Laufzeit jeder Anfrage im Monitor
    - Poti-Code entfernt
2026-10-10 Firmware V2: Tonarm-Logik umgedreht, Echo wird bei 404 in der Geräteliste gesucht
2026-10-10 Firmware V2: OLED-Display mit Titelanzeige, Lautstärke-Einblendung und Startstatus
    - SSD1306 128x32 an I2C (SDA 21, SCL 4), eigene Display-Task
    - Startanzeige: WLAN verbinden, Spotify-Anmeldung, Fehlermeldung
    - Titel, Interpret und Album über /me/player/currently-playing (alle 5 s, nach Sprung nach 1 s)
    - Lange Zeilen laufen durch, kurze stehen still
    - Lautstärke 1,5 s groß mit Balken, Stumm-Anzeige
    - Statuszeile mit Spielt/Pause und Lautstärke
    - Hinweis "Echo nicht erreichbar" auf dem Display
    - Umlaute werden für die Display-Schrift umgewandelt
    - Lautstärke wird nach dem Start einmal abgefragt
    - Neue Bibliothek: ArduinoJson 7
2026-10-11 Display: Titel in großer Schrift, Album und Interpret darunter, Stumm groß
2026-10-11 Firmware: Diagnose und Selbstheilung bei Verbindungsfehlern
2026-10-11 Firmware: automatisch gefundene Echo-ID wird dauerhaft gespeichert
2026-10-11 CAD: Bauteil-Modelle nach cad/bauteile verschoben und von Git ausgeschlossen
    - Heruntergeladene STEP/3MF-Modelle in cad/bauteile/ gesammelt
    - cad/bauteile/ in .gitignore (fremde Lizenzen, nicht weitergeben)
    - Gehäuse V1 liegt in Fusion (Default Project, "RFID-Plattenspieler")
2026-10-11 CAD: Passproben für den ersten Testdruck
    Neuer Ordner cad/passproben mit einer 3MF, in der alle 17 Passproben auf einer Druckplatte liegen, und den einzelnen STLs. Getestet werden Bedienfeld, Display, Tonarmmechanik mit Mikroschalter, Riemenrad auf der Motorwelle, Motorhalter, Tellerlagerung, Plattenzentrierung und Gewindeeinsatz. Im Fusion-Modell sitzen die Mikroschalter-Stifte jetzt nach Messung 1,2 mm über der Unterkante, und das Gegengewicht ist mit dem Tonarm verbunden.
    [01_Deckel_Bedienung_FLIP.stl, 02_Deckel_Display_FLIP.stl, 03_Deckel_Tonarm_FLIP.stl, 04_Tonarm_Saeule.stl, 05_Tonarm_Anschlagring.stl, 06_Tonarm_Arm.stl, 07_Riemenrad_Nabe.stl, 08_Motorhalter.stl]
2026-10-11 Firmware 2.1: Start wird geprüft, Echo wird bei Bedarf geweckt
2026-10-11 Doku: Verkabelung und Schaltplan
    Neue Datei docs/verkabelung.md mit Pinbelegung am ESP32, Versorgung (3V3, 5V, GND), Steckerplan für die Lochrasterplatine (J1 bis J7), Hinweisen zu Tastern, Tonarm-Schalter und Motor sowie einer Checkliste fürs erste Einschalten. Dazu docs/schaltplan.svg als Schaltplan. Im README ist die Datei verlinkt.
2026-10-11 CAD: Übersichtsbild der Passproben
2026-10-12 V2 tesr cad
    [01_Deckel_Tonarm_Schlitz_FLIP.stl, 02_Tonarm_Saeule.stl, 03_Ring_Schaltertraeger.stl, 04_Tonarm_Arm.stl, 05_Tonarm_Stuetze.stl, 06_Deckel_Stuetze_FLIP.stl, 07_Tastenkappe_1_FLIP.stl, 07_Tastenkappe_2_FLIP.stl]
2026-10-12 CCAD: Ersatzstift für die Tonarm-AchseAD: Tonarm für den Druck kopfüber umgebaut
    [04_Tonarm_Arm.stl, 04_Tonarm_Arm_FLIP.stl, m2_stift_20mm.stl, plattenspieler_tonarm.3mf]
2026-10-12 CAD: fertige Druckdateien, Lagerdeckel abnehmbar
    Neuer Ordner cad/druck mit allen Teilen als einzelne, fertig ausgerichtete STLs (Name mit Farbe), dazu LIESMICH.md mit Support, Einstellungen und Montage. Der Deckel des Lagerrings ist jetzt ein eigenes Teil, damit der RC522 montiert werden kann und kein Support im geschlossenen Ring nötig ist. Lagerstift als eigenes Teil, Riemenrad unten plan. Tonarm mit festem Loch an der äußeren Rille statt Bogenschlitz, Mikroschalter fest unter dem Deckel.
    [01_Oberteil_grau.stl, 02_Bodenplatte_grau.stl, 03_Lagerdeckel_grau.stl, 04_Lagerstift_grau.stl, 05_Teller_schwarz.stl, 06_Riemenrad_schwarz.stl, 07_Tonarm_Saeule_schwarz.stl, 08_Tonarm_Anschlagring_schwarz.stl]
2026-10-13 CAD: Bedienhalter für Taster und Drehgeber
    [16_Bedienhalter_Taster_Encoder.stl]
2026-10-13 Shuffle-Knopf, Tastensymbole und Schriftzug (Firmware 2.2)
    - Firmware 2.2: Shuffle-Taster an GPIO 17 schaltet Zufallswiedergabe an/aus, Anzeige auf dem Display
    - Schaltplan und Verkabelung um Shuffle-Taster und Stecker J8 ergänzt
    - Neue Tastenkappen Zurück (links) und Weiter (rechts) mit vertieftem Symbol
    - Puck ersetzt durch Shuffle-Puck mit Symbol, Stößel und Tasterhalter
    - Bohrschablone für das 7-mm-Loch, Loch im Oberteil-Modell ergänzt
    - Schriftzug "M. Khan" in drei Varianten (Lucida, Brush, Corsiva)
    - LIESMICH um neue Teile und Montage erweitert, docs/todo.md angelegt
    [12_Tastenkappe_Weiter_rechts_schwarz.stl, 12_Tastenkappe_Weiter_schwarz.stl, 12_Tastenkappe_Zurueck_links_schwarz.stl, 12_Tastenkappe_Zurueck_schwarz.stl, 14_Puck_schwarz.stl, 14_Shuffle_Halter_beliebig.stl, 14_Shuffle_Puck_schwarz.stl, 14_Shuffle_Stoessel_schwarz.stl]
2026-10-13 Namensschild statt Schriftzug
    [17_Namensschild_FARBWECHSEL_1-0mm.stl, 17_Schriftzug_Brush_schwarz.stl, 17_Schriftzug_Corsiva_schwarz.stl, 17_Schriftzug_Lucida_schwarz.stl]
2026-10-13 Druckteile nach Farbe neu nummeriert
    [05_Riemenrad_grau.stl, 06_Tonarm_Anschlagring_grau.stl, 07_Bedienhalter_Taster_Encoder_grau.stl, 08_Shuffle_Halter_grau.stl, 09_Shuffle_Stoessel_grau.stl, 10_Bohrschablone_Shuffle_grau.stl, 11_Namensschild_grau_ab_1-0mm_schwarz.stl, 12_Teller_schwarz.stl]
2026-10-21 Firmware: Motor im Vollschritt, Drehknopf auf GPIO 15
    - Motor im Vollschritt mit 8 ms pro Schritt (etwa 3,7 U/min) für mehr Drehmoment
    - Drehgeber-Taster SW von GPIO 13 auf GPIO 15 verlegt
    - verkabelung.md angepasst
2026-10-21 Passproben: Tastenkappen-Tests
    - 09 gespiegelte Tastenkappe, 10 und 11 Kappen mit 2,2 und 1,8 mm unter dem Kragen
    [09_Tastenkappe_gespiegelt_Test.stl, 10_Tastenkappe_Test_unten_2-2mm.stl, 11_Tastenkappe_Test_unten_1-8mm.stl]
2026-10-21 Druckteile: neuer Antrieb, zweiteiliger Teller, Tastenkappen, Encoder-Stütze
    - Riemenrad V3 mit 6 mm hoher Rille und größerem Rillengrund, Riemenkäfig um das Riemenrad
    - Teller zweiteilig: Becher mit 9 mm hoher Riemenrille, flacher Teller V2 mit Mitnehmerstiften
    - Zentrierstummel als eigenes Teil, alter Teller kopfüber druckbar
    - Tastenkappen 9,3 mm breit, unten 2,2 mm, oben 6,6 mm
    - Encoder-Stütze unter dem KY-040
    - Namensschild als zweifarbige 3MF für AMS plus Schrift-Einlage
    - Riemenrad V2 und Kappe als nicht mehr nötig markiert, LIESMICH aktualisiert
    [05_Riemenrad_V2_grau.stl, 05_Riemenrad_V3_grau.stl, 05b_Riemenrad_Kappe_eng_grau.stl, 05b_Riemenrad_Kappe_locker_grau.stl, 05c_Riemenkaefig_grau.stl, 07b_Encoder_Stuetze_grau.stl, 11_Namensschild_AMS_zweifarbig.3mf, 11b_Namensschild_Schrift_Einlage_grau.stl]
2026-10-22 Firmware: Motor auf 12 ms pro Schritt
    - MOTOR_SCHRITT_MS von 8 auf 12 ms, etwa 2,4 U/min am Motor, mehr Drehmomentreserve gegen Ruckeln
2026-10-22 Tasten getauscht, Auflage für den Tonarm-Schalter
    - Firmware: Weiter auf GPIO 33, Zurück auf GPIO 32 (beim Verkabeln vertauscht)
    - verkabelung.md und schaltplan.svg angepasst
    - 06b_Schalterhebel_Auflage_grau: vier Plättchen 0,6 bis 1,8 mm, erhöhen den Hebel vom Mikroschalter, damit der Tonarm ihn erreicht
    [06b_Schalterhebel_Auflage_grau.stl]
2026-10-23 Spannrolle neu: angedruckte Achse, nur kurze M2
    [04b_Anlaufring_grau.stl, 05d_Spannrolle_Set_grau.stl, 06b_Schalterhebel_Auflage_5x6x1-8_grau.stl]
2026-10-23 Translate project to English, clean up and add photos Firmware, test sketch and Spotify tool translated to English including names and display texts, English README with photos, wiring guide and prin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
    [01_Deckel_Bedienung_FLIP.stl, 01_Deckel_Tonarm_Schlitz_FLIP.stl, 01_top_case_grey.stl, 02_Deckel_Display_FLIP.stl, 02_Tonarm_Saeule.stl, 02_base_plate_grey.stl, 03_Deckel_Tonarm_FLIP.stl, 03_Ring_Schaltertraeger.stl]
2026-10-25 Firmware: motor watchdog and status log
    motorTask now counts its steps. checkMotor() in loop() restarts the motor task if the platter should turn but no step was made for 3 s, and restarts the ESP32 after more than 3 motor restarts within an hour. Prints a motor status line to the serial monitor every minute. Motor task creation moved into startMotorTask(), which also sets up the pins again.
